warmchang/PLFM_RADAR/(list of files, cad)

Other CAD files:
8_Utils/Mechanical_Drawings/Waveguide.dwg
8_Utils/Mechanical_Drawings/SlipRing.dwg
