warmchang/PLFM_RADAR/(commit log)

2026-03-20 Integrate CA-CFAR detector: replace fixed-threshold comparator with adaptive sliding-window CFAR engine (22/22 regression PASS)
    - Add cfar_ca.v: CA/GO/SO-CFAR with BRAM magnitude buffer, host-configurable
    guard cells, training cells, alpha multiplier, and mode selection
    - Replace old threshold detector block in radar_system_top.v with cfar_ca
    instantiation; backward-compatible (cfar_enable defaults to 0)
    - Add 5 new host registers: guard (0x21), train (0x22), alpha (0x23),
    mode (0x24), enable (0x25)
    - Expose doppler_frame_done_out from radar_receiver_final for CFAR frame sync
    - Add tb_cfar_ca.v standalone testbench (14 tests, 24 checks)
    - Add Group 14 E2E tests: 13 checks covering rang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
    [cfar_ca.v, radar_receiver_final.v, radar_system_top.v, tb_cfar_ca.v, tb_radar_receiver_final.v, tb_system_e2e.v]
2026-03-20 Full-chain MTI+CFAR real-data co-simulation: bit-exact match across all 10247 checkpoints (decim->MTI->Doppler->DC notch->CFAR) using ADI CN0566 data
2026-05-15 3D Waveguide
    [Waveguide.dwg]
