warmchang/PLFM_RADAR/(notices)

Notices in the files:
README.md:
License: MIT
Hardware: CERN-OHL-P
